lethalbit/aki-eda/README.md

# aki-eda
A collection of my custom libraries and symbols and the like for KiCad, and a collection of GDS cell libraries for ASIC stuff
