lethalbit/aki-eda/(commit log)

2021-07-04 Fixed the SCSI connector footprint
2021-08-06 Added xenia silkscreen to the graphics library
2022-02-23 moved the lib/brd dirs to the kicad subdir
    [jlc-4-layer.kicad_pcb]
2022-02-28 etc: added the LEF 2 kicad_sym script to generate KiCad symbol libraries for PDK LEF files
2022-02-28 added the sky130 kicad symbols
2022-03-04 etc: fixed up the lef2kicad_sym.py script to include more metadata for use in the LVS stage
2023-10-04 Did a mass re-orginization of my messy kicad libraries
2023-10-04 Updated footprints, prior to re-orginization
2023-10-04 Removed the old pre-kicad-6 libraries
2023-10-05 removed the old PDK libs in favor of https://github.com/lethalbit/kicad-pdk-libs
2024-05-17 Added AK2A Oscilator footprint
2024-05-17 Added KEMET EB SMD AluPoly footprint
2024-06-12 KiCad library upgrade? Maybe? Who knows
2024-06-12 Fixed the footprint for the AP3428/A
2024-06-12 Fixed the paste on the OnSemi SO-8FL-488AA footprint so it's not a giant hole in the stencile
2024-10-05 cleaned up the superfund site that was my PCIe footprint library
2024-10-05 Added the proper name for the Centroics 50 pin connector
2024-10-05 Added the HD-50, HD-68, and VHDCI connectors
2024-10-05 Added the mating connector for the 1014458-10x80xLF
2024-10-05 updated connectors library
2024-10-05 added ST UFDFPN footprint
2024-10-05 added SOT-886 footprint
2024-10-06 Added Mill-Max 02x04 Pogo connector
2025-06-15 Un-fucked the turbo-cursed pad geometry and made the paste-in-hole stuff a bit better for the HSEC8, it no longer lagges the PCB Editor, yay
2025-09-15 Added FFVB676 Footprint
2025-09-16 Fixed up the PCI-X socket footprint
2025-09-16 Added PCIe x8 and x16 socket footprints
2025-09-16 Cleanup on the samtec HSEC8-140 footprint
2025-09-21 connectors: Added Conn_02x60_Odd_Even_MP
2025-09-21 connectors: Added Amphenol BergStak HS Connectors
2025-09-21 connectors: Fixed pins on Conn_02x60_Odd_Even_MP
